Gherkin/tmc2240-breakout/README.md

# TMC2240 Breakout
A small breakout board for the (formerly) Trinamatic [TMC2240 Stepper Motor Driver](https://www.analog.com/en/products/tmc2240.html)  

[Interactive BOM/PCB](https://gherkin.github.io/tmc2240-breakout/)  
[Interactive 3D Model](https://gherkin.github.io/tmc2240-breakout/3dmodel.html)  
[Schematic pdf](https://gherkin.github.io/tmc2240-breakout/tmc2240-breakout.pdf)
