Gherkin/tmc2240-breakout/symbols - footprints/ul_TMC2240ATJ-/21-0140_T32555C_TRI.step

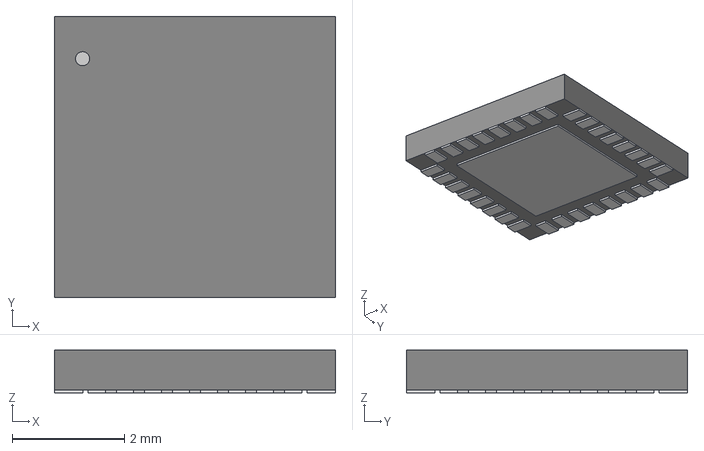
[picture p1: CAD file, 2025-03-27]
symbols - footprints/ul_TMC2240ATJ-/21-0140_T32555C_TRI.step
5.00 x 5.00 x 0.765 mm
