Gherkin/tmc2240-breakout/tmc2240-breakout.pdf

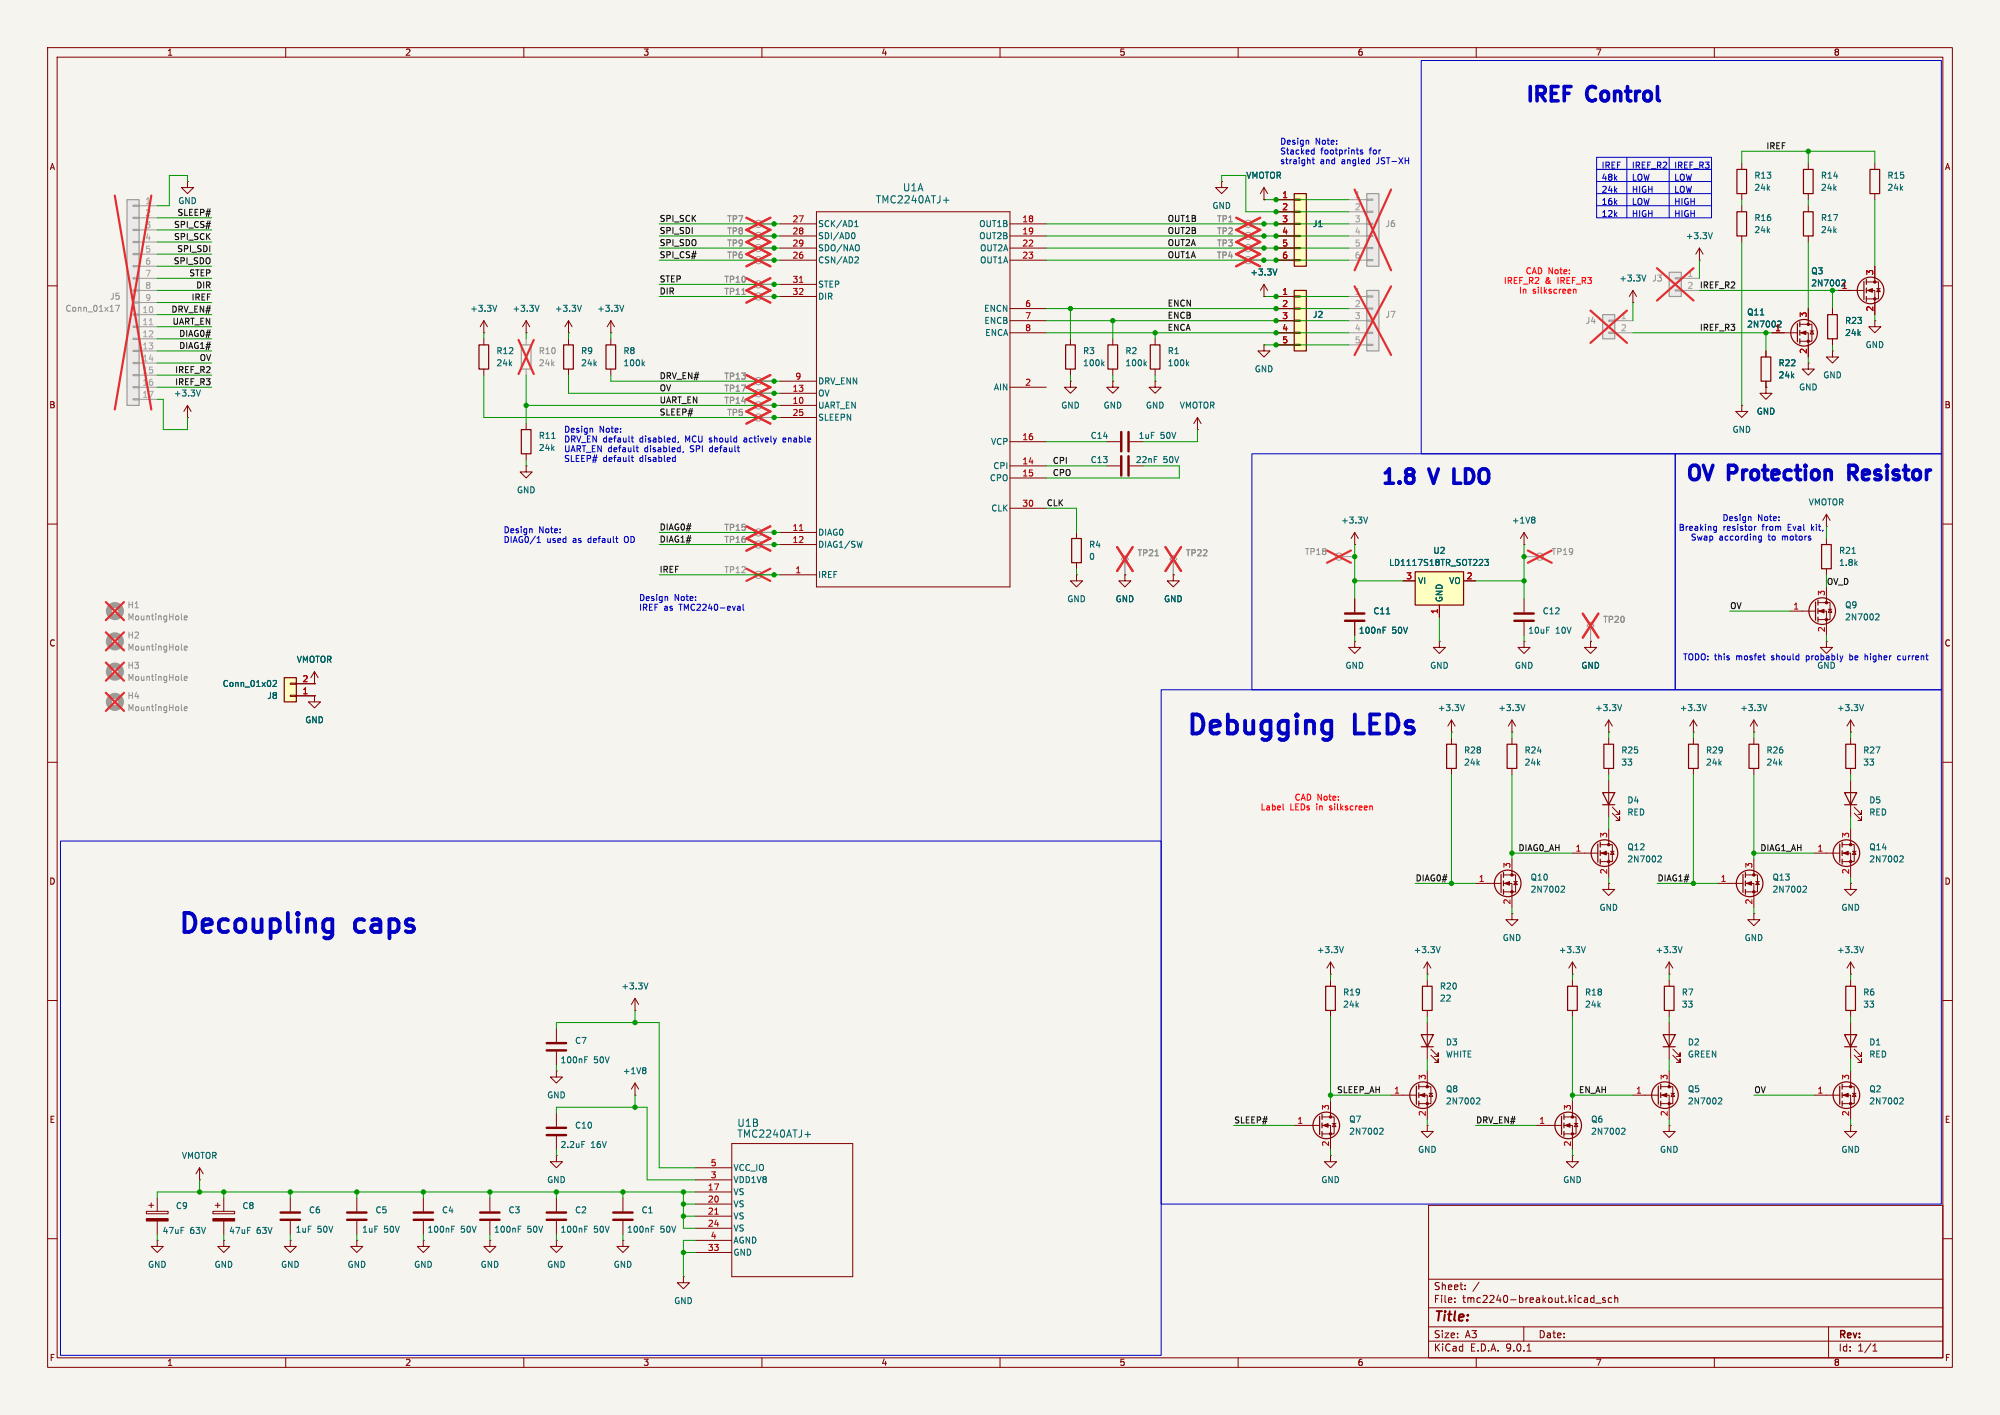
[picture p2: page 1]

In silkscreen IREF Control

CAD Note: Label LEDs in silkscreen

Id: 1/1 Title: File: tmc2240-breakout.kicad_sch Sheet: /
