Gherkin/tmc2240-breakout/tmc2240-breakout.kicad_pcb

## KiCad design tmc2240-breakout.kicad_pcb (2025-04-21)

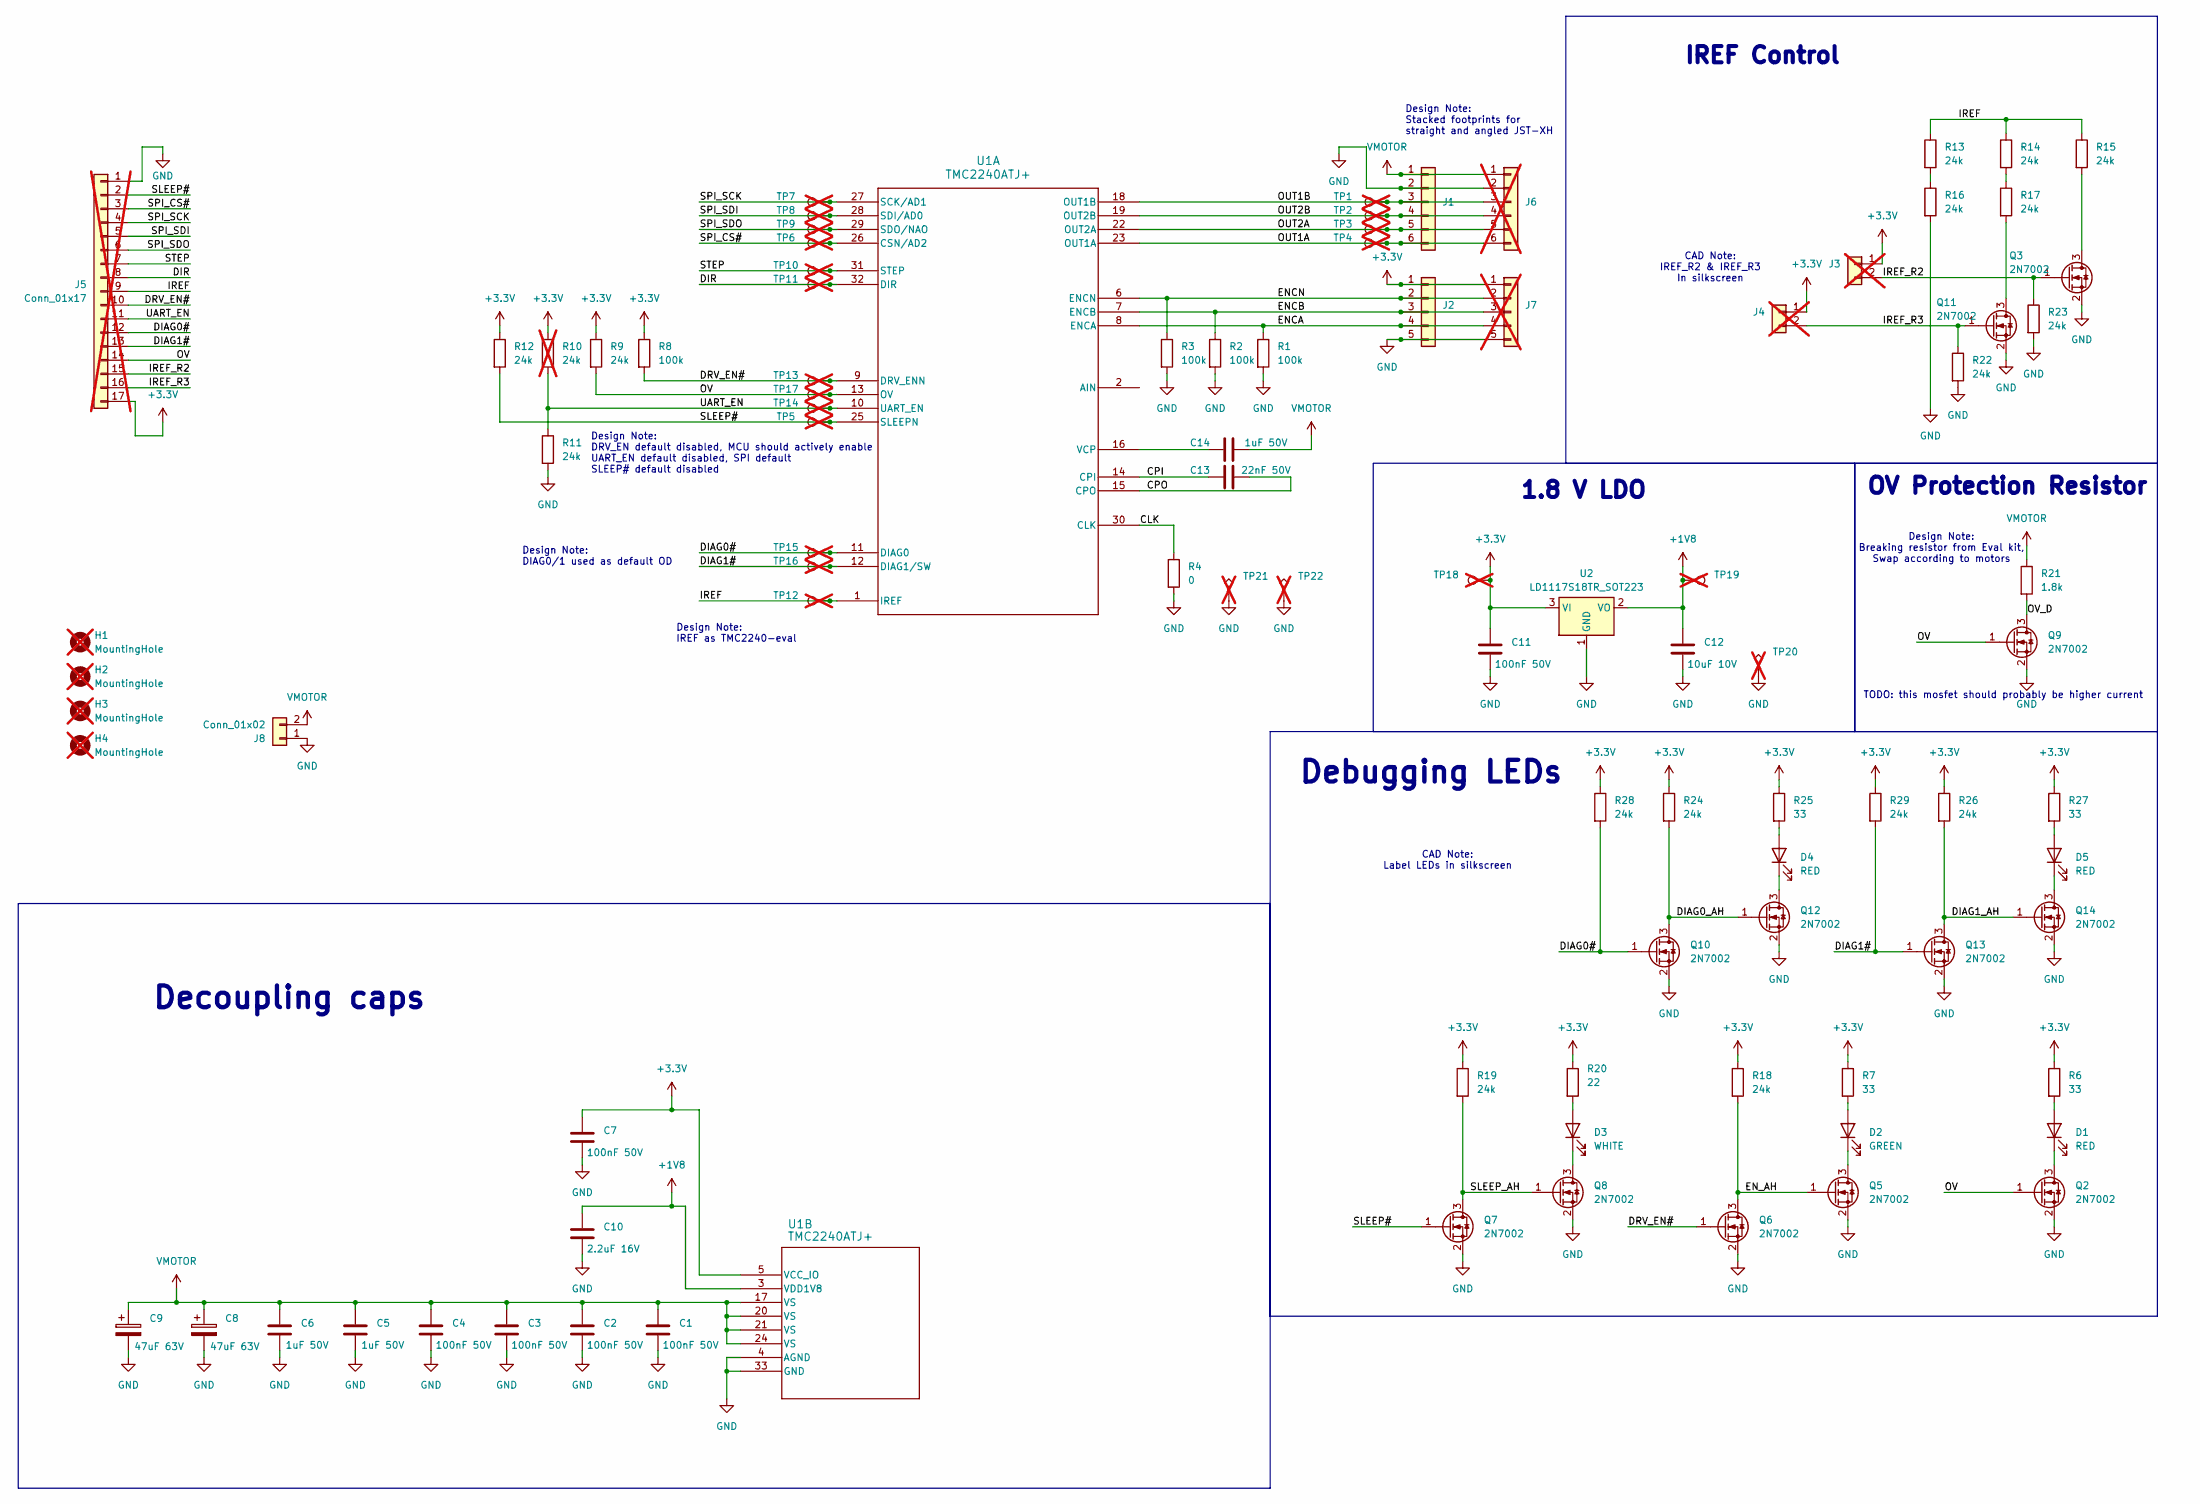
[picture p3: schematic tmc2240-breakout.kicad_sch]

Parts:
C1, C2, C3, C4, C7, C11: 100nF 50V; C_0402_1005Metric; LCSC C307331
C5, C6, C14: 1uF 50V; C_0603_1608Metric; LCSC C15849
C8, C9: 47uF 63V; CP_Elec_6.3x7.7; LCSC C72523
C10: 2.2uF 16V; C_0603_1608Metric; LCSC C23630
C12: 10uF 10V; C_0603_1608Metric; LCSC C19702
C13: 22nF 50V; C_0402_1005Metric; LCSC C1532
D1, D4, D5: RED; LED_0805_2012Metric; LCSC C84256
D2: GREEN; LED_0805_2012Metric; LCSC C2297
D3: WHITE; LED_0805_2012Metric; LCSC C34499
H1, H2, H3, H4: MountingHole; MountingHole_3.2mm_M3; not fitted
J1: Conn_01x06; CONN-TH_6P-P2.50_DEALON_XH-W-6A; LCSC C5160923
J2: Conn_01x05; CONN-TH_5P-P2.50_HDGC2501WR-5P; LCSC C5175258
J3, J4: Conn_01x02; PinHeader_1x02_P2.54mm_Vertical; LCSC C7429641; not fitted
J5: Conn_01x17; PinHeader_1x17_P2.54mm_Vertical; not fitted
J6: Conn_01x06; JST_XH_B6B-XH-A_1x06_P2.50mm_Vertical; LCSC C161873; not fitted
J7: Conn_01x05; JST_XH_B5B-XH-A_1x05_P2.50mm_Vertical; LCSC C125320; not fitted
J8: Conn_01x02; TerminalBlock_Phoenix_MKDS-1,5-2_1x02_P5.00mm_Horizontal
Q2, Q3, Q5, Q6, Q7, Q8, Q9, Q10, Q11, Q12, Q13, Q14: 2N7002; SOT-23; LCSC C8545
R1, R2, R3, R8: 100k; R_0402_1005Metric; LCSC C25530
R4: 0; R_0402_1005Metric; LCSC C60485
R6, R7, R25, R27: 33; R_0402_1005Metric; LCSC C25105
R9, R11, R12, R13, R14, R15, R16, R17, R18, R19, R22, R23, R24, R26, R28, R29: 24k; R_0201_0603Metric; LCSC C23352
R10: 24k; R_0201_0603Metric; LCSC C23352; not fitted
R20: 22; R_0402_1005Metric; LCSC C25092
R21: 1.8k; R_2512_6332Metric; LCSC C137011
TP1, TP2, TP3, TP4, TP5, TP6, TP7, TP8, TP9, TP10, TP11, TP12, TP13, TP14, TP15, TP16, TP17, TP18, TP19: TestPoint; TestPoint_THTPad_D1.0mm_Drill0.5mm; not fitted
TP20, TP21, TP22: TestPoint_Alt; TestPoint_THTPad_1.0x1.0mm_Drill0.5mm; not fitted
U1: TMC2240ATJ+; 21-0140_T3255+5C_TRI; LCSC C7429724
U2: LD1117S18TR_SOT223; SOT-223-3_TabPin2; LCSC C80598

Connections:
+1V8: C10.1, C12.1, TP19.1, U1.3 (VDD1V8), U2.2 (VO)
+3.3V: C7.1, C11.1, J2.1, J3.1, J4.1, J5.17, J7.1, R6.1, R7.1, R8.1, R9.1, R10.1, R12.1, R18.1, R19.1, R20.1, R24.1, R25.1, R26.1, R27.1, R28.1, R29.1, TP18.1, U1.5 (VCC_IO), U2.3 (VI)
/CLK: R4.1, U1.30 (CLK)
/CPI: C13.1, U1.14 (CPI)
/CPO: C13.2, U1.15 (CPO)
/DIAG0#: J5.12, Q10.1 (G), R28.2, TP15.1, U1.11 (DIAG0)
/DIAG0_AH: Q10.3 (D), Q12.1 (G), R24.2
/DIAG1#: J5.13, Q13.1 (G), R29.2, TP16.1, U1.12 (DIAG1/SW)
/DIAG1_AH: Q13.3 (D), Q14.1 (G), R26.2
/DIR: J5.8, TP11.1, U1.32 (DIR)
/DRV_EN#: J5.10, Q6.1 (G), R8.2, TP13.1, U1.9 (DRV_ENN)
/ENCA: J2.4, J7.4, R1.1, U1.8 (ENCA)
/ENCB: J2.3, J7.3, R2.1, U1.7 (ENCB)
/ENCN: J2.2, J7.2, R3.1, U1.6 (ENCN)
/EN_AH: Q5.1 (G), Q6.3 (D), R18.2
/IREF: J5.9, R13.1, R14.1, R15.1, TP12.1, U1.1 (IREF)
/IREF_R2: J3.2, J5.15, Q3.1 (G), R23.1
/IREF_R3: J4.2, J5.16, Q11.1 (G), R22.1
/OUT1A: J1.6, J6.6, TP4.1, U1.23 (OUT1A)
/OUT1B: J1.3, J6.3, TP1.1, U1.18 (OUT1B)
/OUT2A: J1.5, J6.5, TP3.1, U1.22 (OUT2A)
/OUT2B: J1.4, J6.4, TP2.1, U1.19 (OUT2B)
/OV: J5.14, Q2.1 (G), Q9.1 (G), R9.2, TP17.1, U1.13 (OV)
/OV_D: Q9.3 (D), R21.2
/SLEEP#: J5.2, Q7.1 (G), R12.2, TP5.1, U1.25 (SLEEPN)
/SLEEP_AH: Q7.3 (D), Q8.1 (G), R19.2
/SPI_CS#: J5.3, TP6.1, U1.26 (CSN/AD2)
/SPI_SCK: J5.4, TP7.1, U1.27 (SCK/AD1)
/SPI_SDI: J5.5, TP8.1, U1.28 (SDI/AD0)
/SPI_SDO: J5.6, TP9.1, U1.29 (SDO/NAO)
/STEP: J5.7, TP10.1, U1.31 (STEP)
/UART_EN: J5.11, R10.2, R11.1, TP14.1, U1.10 (UART_EN)
GND: C1.2, C2.2, C3.2, C4.2, C5.2, C6.2, C7.2, C8.2, C9.2, C10.2, C11.2, C12.2, J1.2, J2.5, J5.1, J6.2, J7.5, J8.1, Q2.2 (S), Q3.2 (S), Q5.2 (S), Q6.2 (S), Q7.2 (S), Q8.2 (S), Q9.2 (S), Q10.2 (S), Q11.2 (S), Q12.2 (S), Q13.2 (S), Q14.2 (S), R1.2, R2.2, R3.2, R4.2, R11.2, R16.2, R22.2, R23.2, TP20.1, TP21.1, TP22.1, U1.4 (AGND), U1.33 (GND), U2.1 (GND)
unnamed: D1.2 (A), R6.2
unnamed: D1.1 (K), Q2.3 (D)
unnamed: D2.2 (A), R7.2
unnamed: D2.1 (K), Q5.3 (D)
unnamed: D3.2 (A), R20.2
unnamed: D3.1 (K), Q8.3 (D)
unnamed: D4.2 (A), R25.2
unnamed: D4.1 (K), Q12.3 (D)
unnamed: D5.2 (A), R27.2
unnamed: D5.1 (K), Q14.3 (D)
unnamed: Q3.3 (D), R15.2
unnamed: Q11.3 (D), R17.2
unnamed: R13.2, R16.1
unnamed: R14.2, R17.1
unnamed: C14.1, U1.16 (VCP)
VMOTOR: C1.1, C2.1, C3.1, C4.1, C5.1, C6.1, C8.1, C9.1, C14.2, J1.1, J6.1, J8.2, R21.1, U1.17 (VS), U1.20 (VS), U1.21 (VS), U1.24 (VS)

Notes on the sheet:
IREF Control
Design Note: DRV_EN default disabled, MCU should actively enable UART_EN default disabled, SPI default SLEEP# default disabled
TODO: this mosfet should probably be higher current
Design Note: DIAG0/1 used as default OD
1.8 V LDO
Debugging LEDs
Design Note: Breaking resistor from Eval kit, Swap according to motors
CAD Note: Label LEDs in silkscreen
OV Protection Resistor
Design Note: IREF as TMC2240-eval
Design Note: Stacked footprints for straight and angled JST-XH
Decoupling caps
CAD Note: IREF_R2 & IREF_R3 In silkscreen

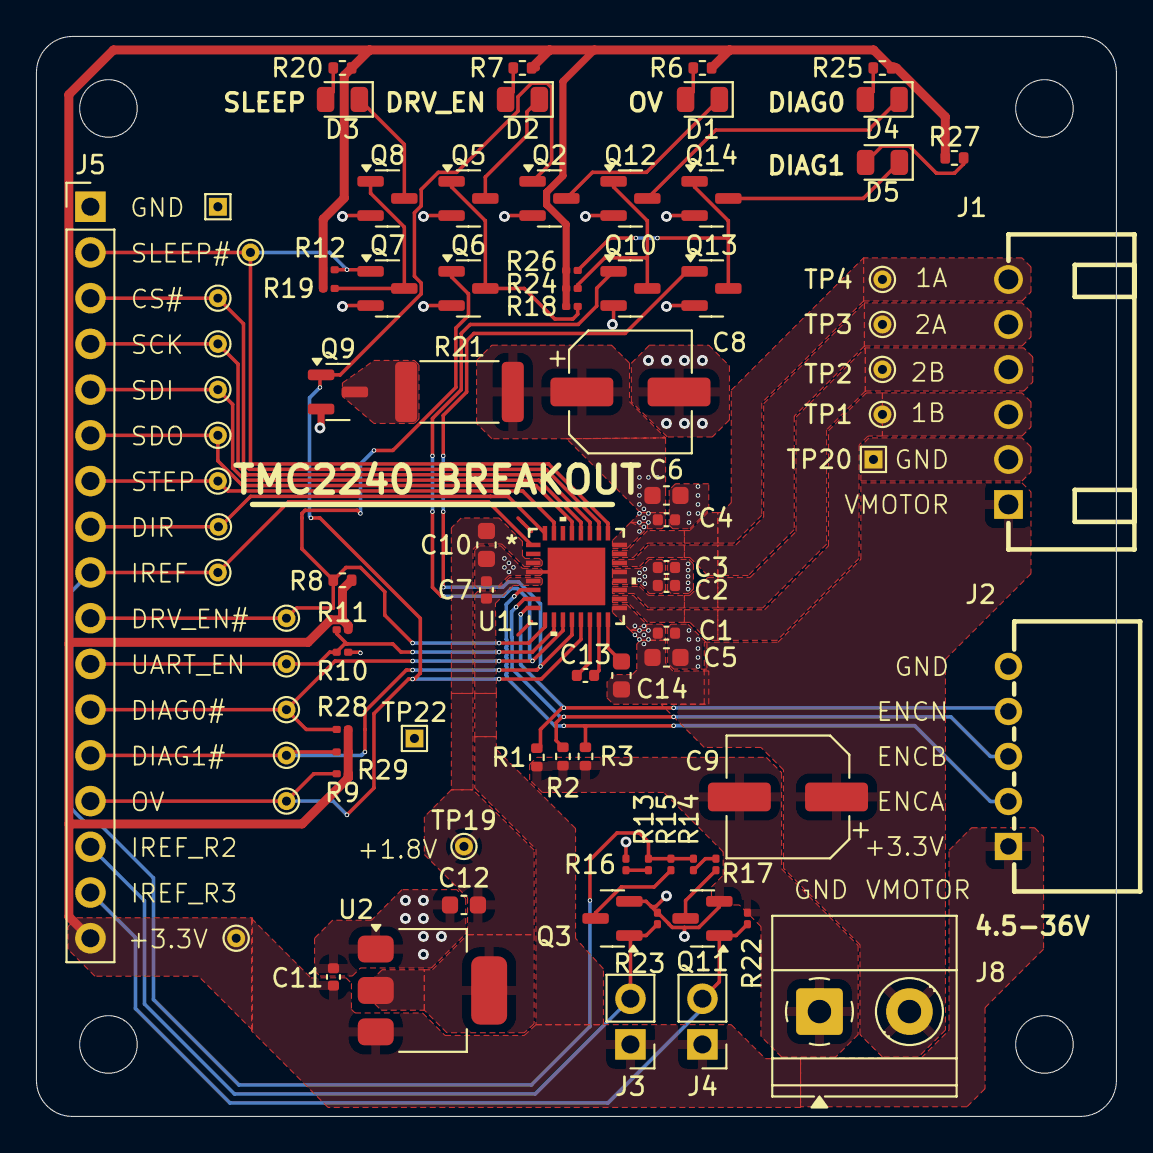
[picture p4: board tmc2240-breakout.kicad_pcb from above]

Board: 2 copper layers, 60.0 x 60.0 mm, 93 parts (1 on the bottom side), 48 nets.

Other parts of the board:
QR*****: tmc2240-breakout; //github.com/Gherkin/tmc2240-breakout
