Gherkin/tmc2240-breakout/(commit log)

2025-03-27 did some stuff
    [2240-breakout.kicad_sch]
2025-03-29 renamed kicad files correctly
    [tmc2240-breakout.kicad_pcb, tmc2240-breakout.kicad_sch]
2025-03-29 added git hooks
    [tmc2240-breakout.kicad_pcb]
2025-03-30 did more stuff
    [tmc2240-breakout.kicad_sch]
2025-04-01 did some minor things, organized schematic a bit
    [tmc2240-breakout.kicad_sch]
2025-04-02 did a lot of sourcing of lcsc, most is basic
    [tmc2240-breakout.kicad_sch]
2025-04-06 did more sourcing and footprints
    [tmc2240-breakout.kicad_sch]
2025-04-08 did more sourcing and fixed footprints
    [tmc2240-breakout.kicad_sch]
2025-04-08 did some pcb placement
    [tmc2240-breakout.kicad_pcb, tmc2240-breakout.kicad_sch]
2025-04-08 did some more placements
    [tmc2240-breakout.kicad_pcb]
2025-04-09 started doing some routing
    [tmc2240-breakout.kicad_pcb, tmc2240-breakout.kicad_sch]
2025-04-09 trying to export 3d model
    [tmc2240-breakout.kicad_pcb]
2025-04-10 did some more pcb layout
    [tmc2240-breakout.kicad_pcb]
2025-04-11 did some layouting
    [tmc2240-breakout.kicad_pcb]
2025-04-18 old commit
    [tmc2240-breakout.kicad_pcb]
2025-04-18 more layouting
    [tmc2240-breakout.kicad_pcb]
2025-04-19 more pcb layout
    [tmc2240-breakout.kicad_pcb]
2025-04-19 did some more layouting
    [tmc2240-breakout.kicad_pcb]
2025-04-21 more pcb layouting
    [tmc2240-breakout.kicad_pcb, tmc2240-breakout.kicad_sch]
2025-04-21 pretty much done with layout, review time
    [tmc2240-breakout.kicad_pcb, tmc2240-breakout.kicad_sch]
